4eef/Sonar/Media/testing.jpg

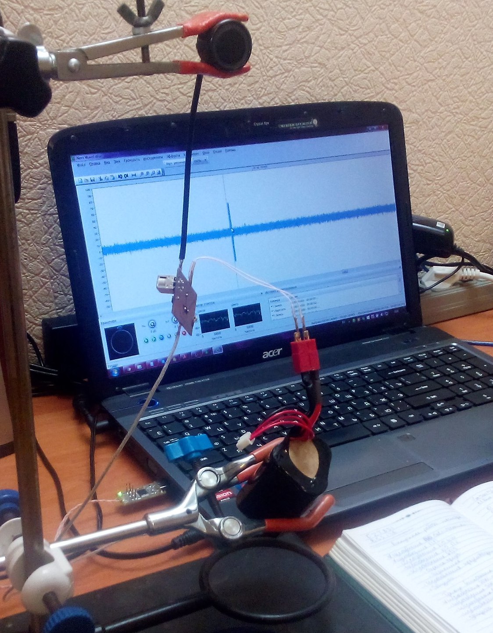
Media/testing.jpg
