4eef/Sonar/Media/prototype.JPG

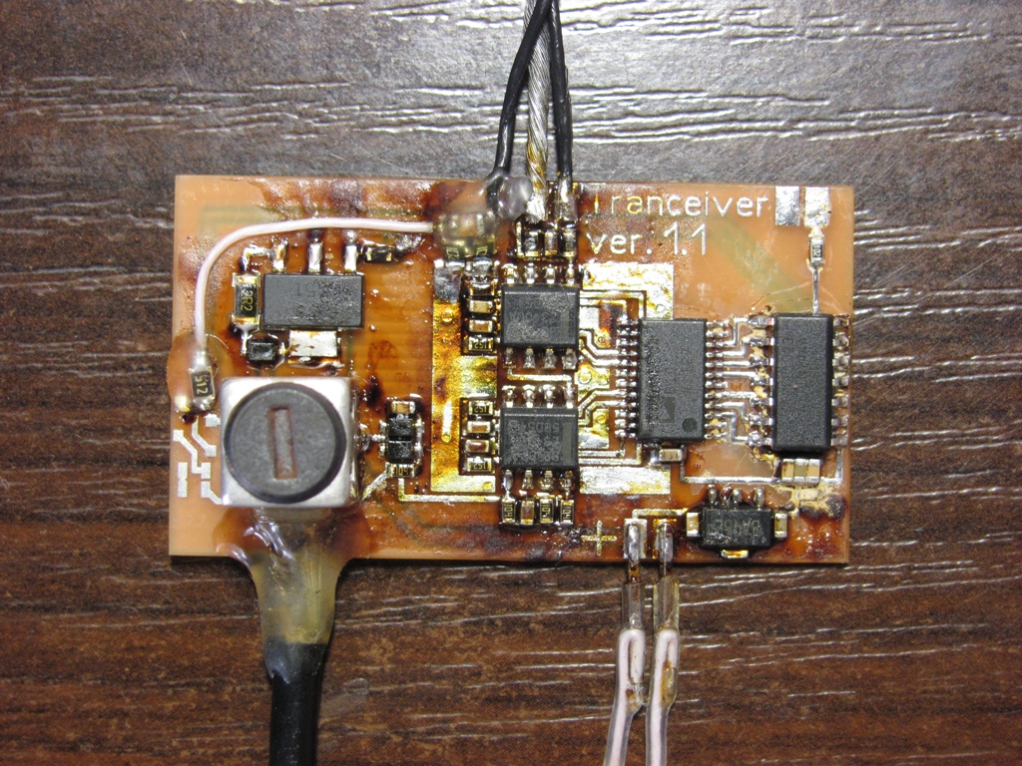
Media/prototype.JPG
