4eef/Sonar/Hardware/scheme.gif

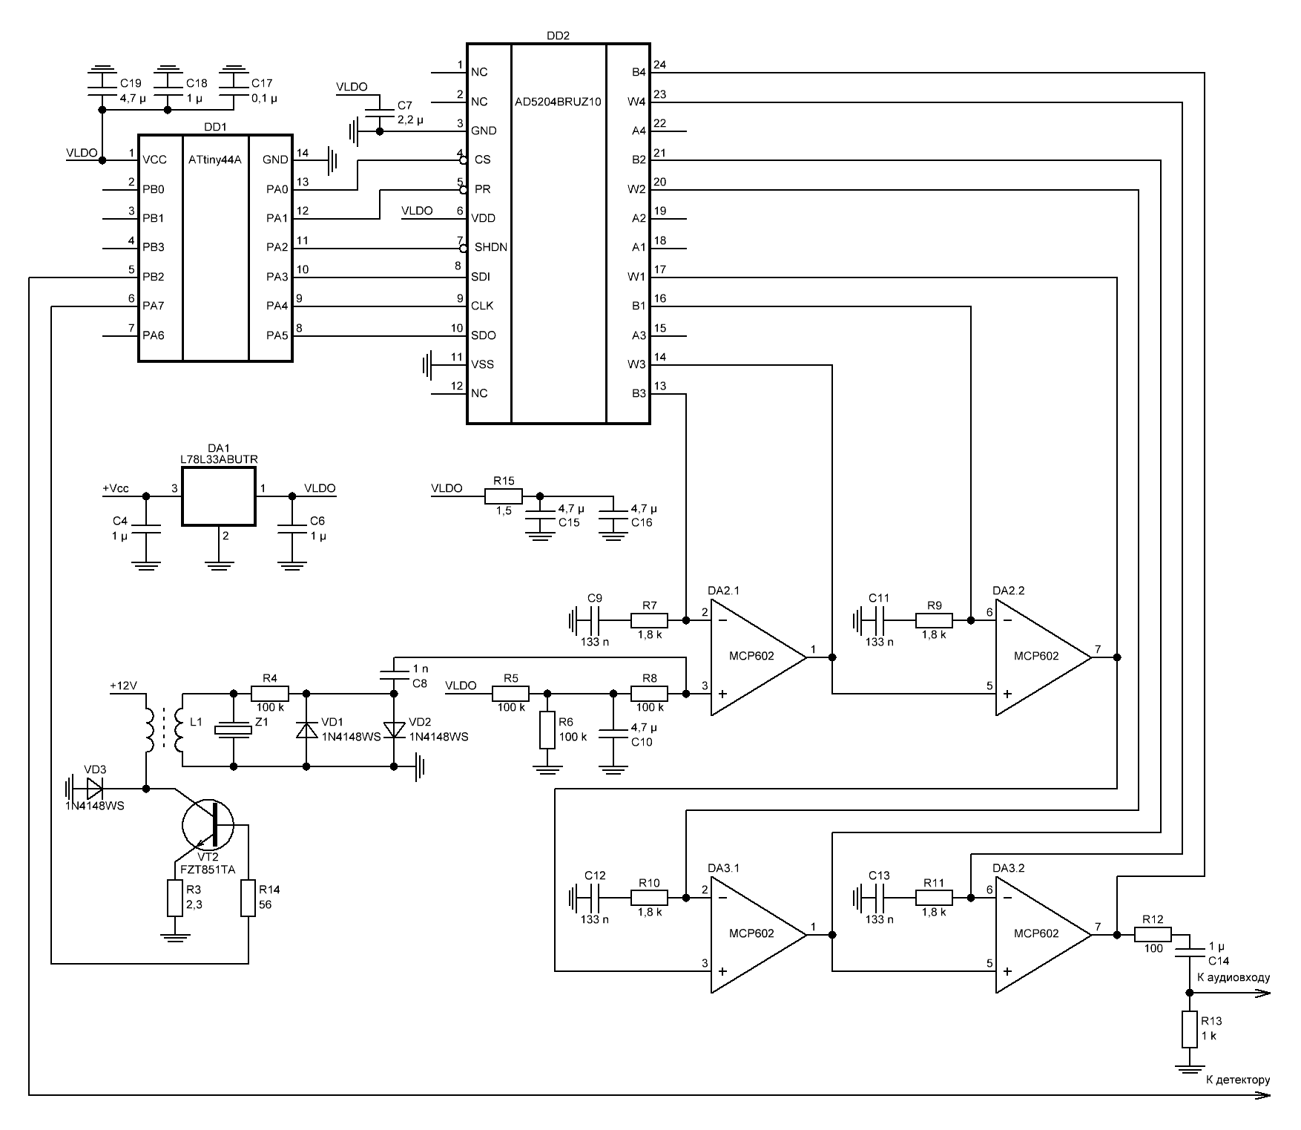
Hardware/scheme.gif
