4eef/Sonar/(list of files, cad)

Other CAD files:
Software/Tranceiver_v1_1.obj
