4eef/Sonar/(list of files, drawings)

Other design files:
Hardware/sonar.lay6
